BBroadbent/NotSmart-Speaker/PCB/NotSmart-Speaker/NotSmart-Speaker.kicad_pcb

## KiCad design PCB/NotSmart-Speaker/NotSmart-Speaker.kicad_pcb (2026-10-10)

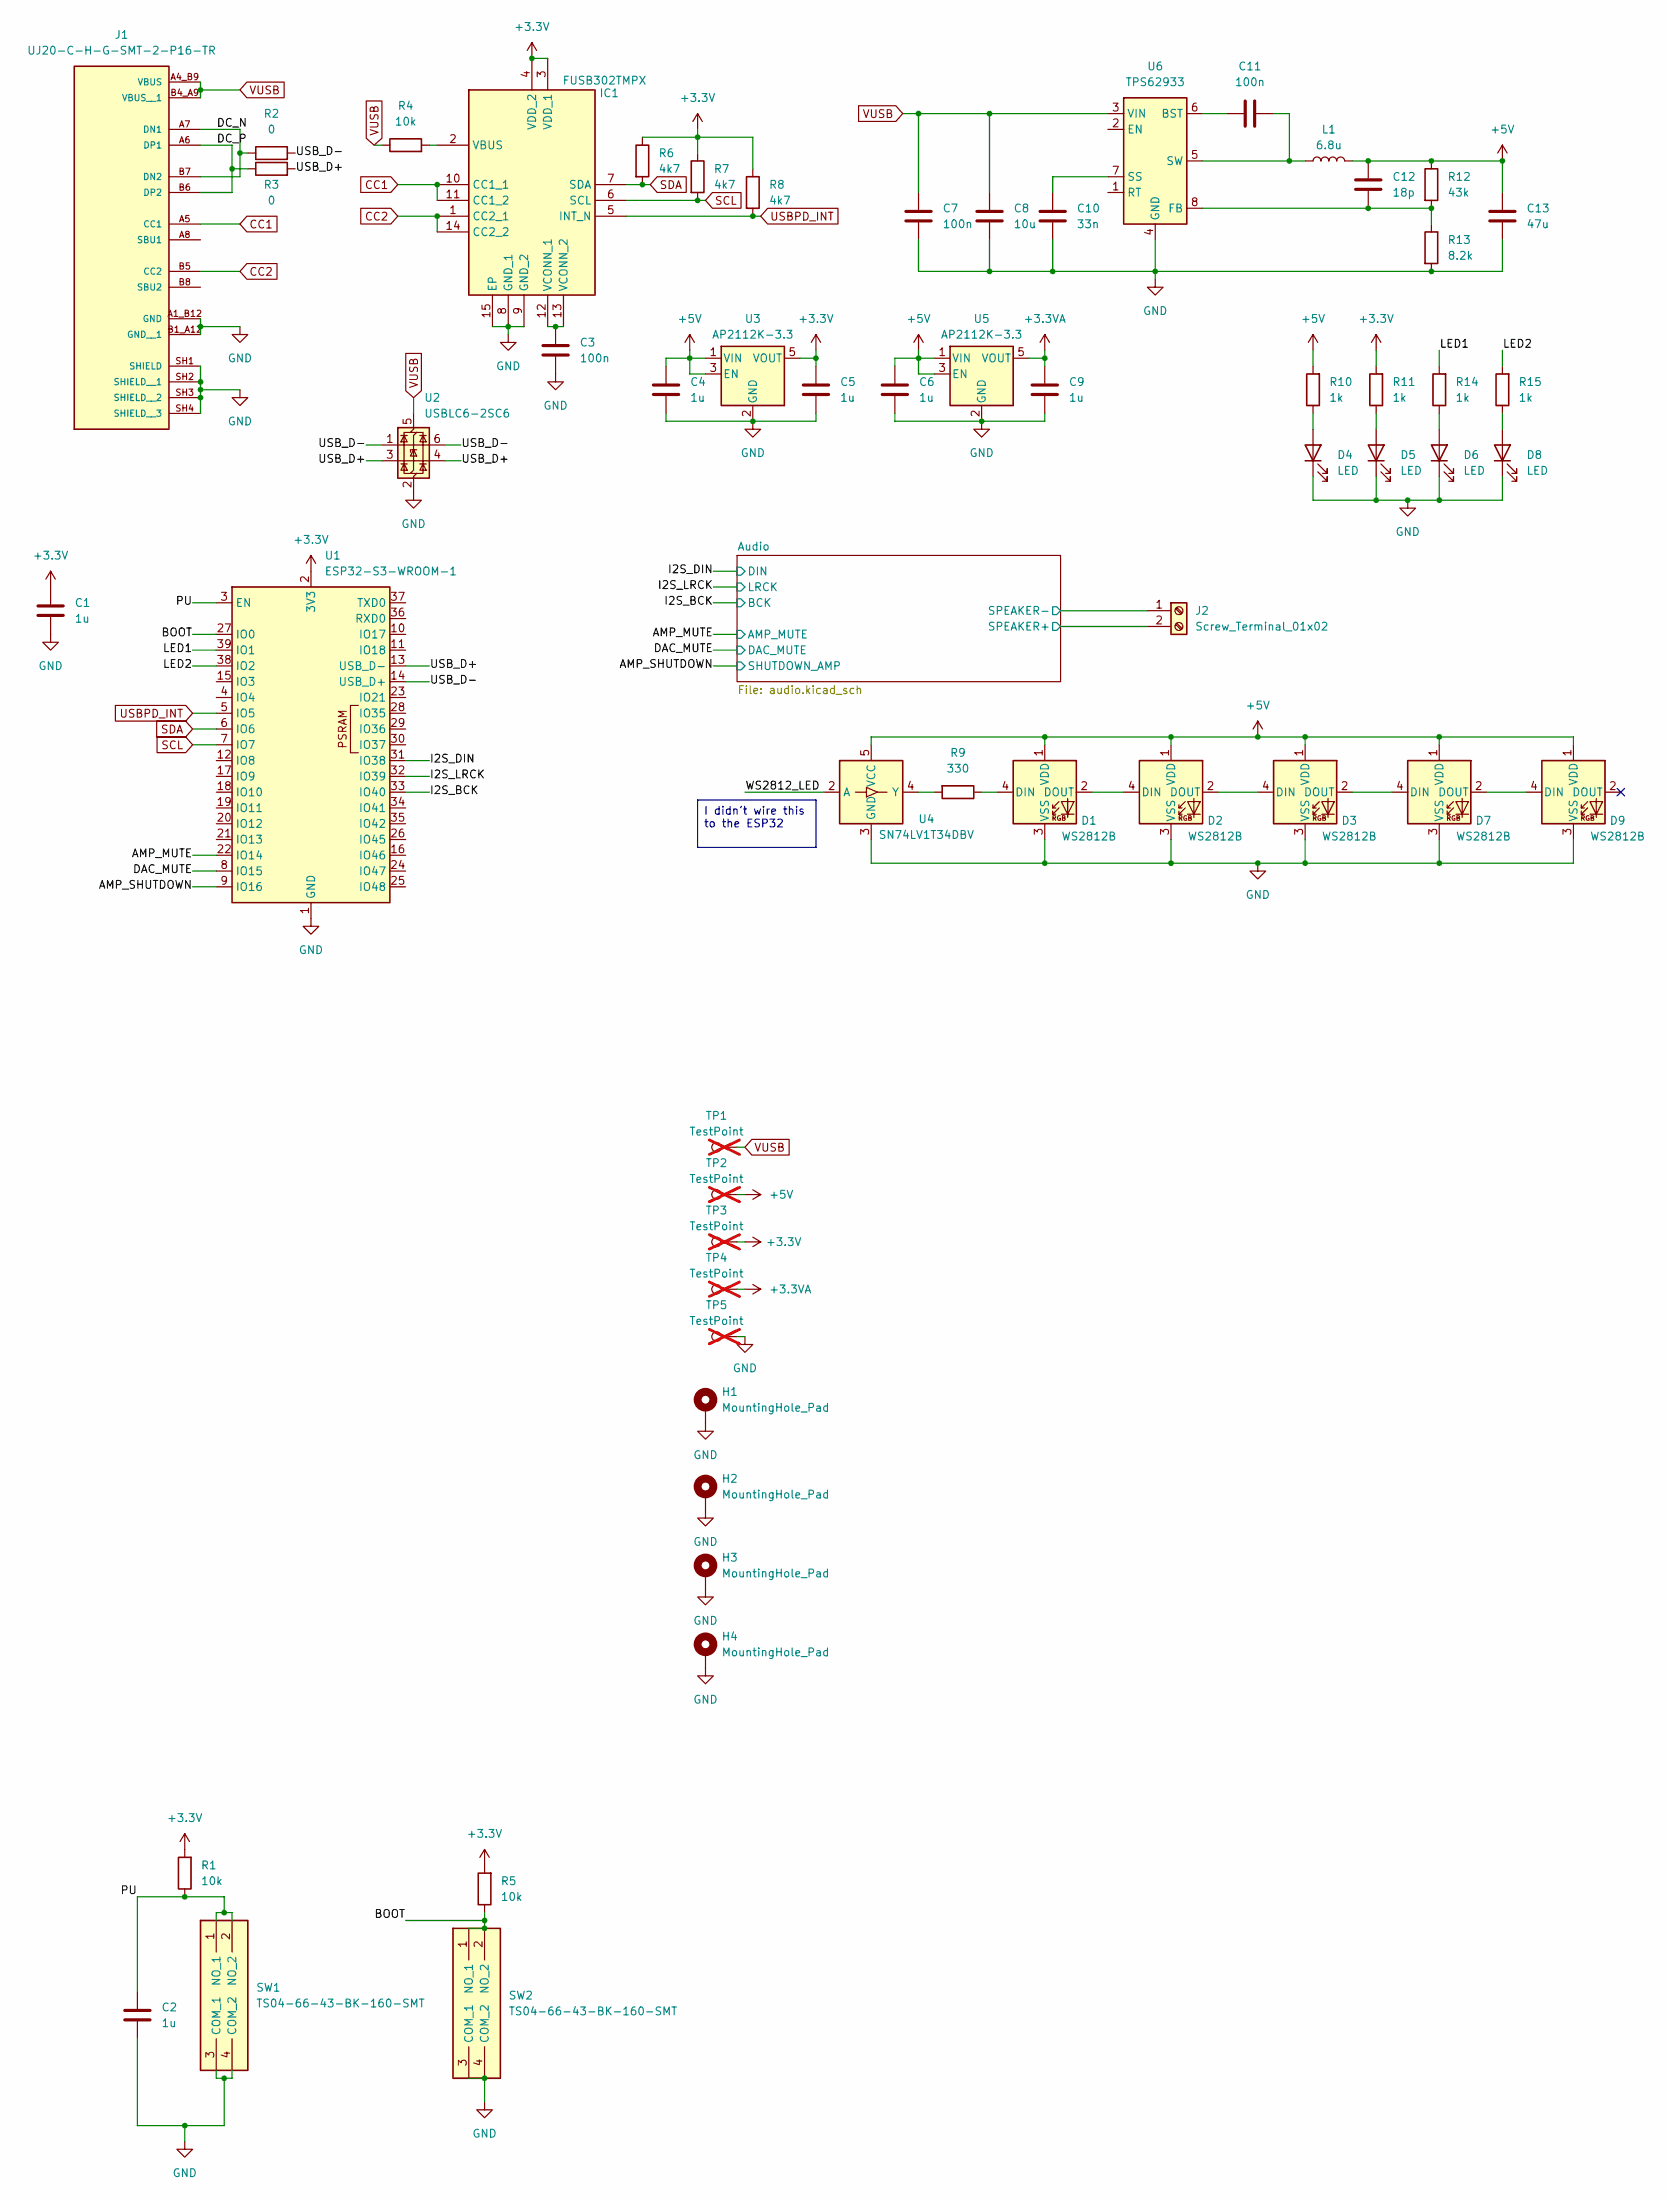
[picture p1: schematic NotSmart-Speaker.kicad_sch]

Parts:
C1, C2, C4, C5, C6, C9: 1u; C_0805_2012Metric_Pad1.18x1.45mm_HandSolder; Manufacturer_Part_Number GRM219R61H105MA73D
C3, C7, C11: 100n; C_0805_2012Metric_Pad1.18x1.45mm_HandSolder; Manufacturer_Part_Number 885012207098R
C8: 10u; C_0805_2012Metric_Pad1.18x1.45mm_HandSolder; Manufacturer_Part_Number GRM21BR61H106KE43K
C10: 33n; C_0805_2012Metric_Pad1.18x1.45mm_HandSolder; Manufacturer_Part_Number 885012207095
C12: 18p; C_0805_2012Metric_Pad1.18x1.45mm_HandSolder; Manufacturer_Part_Number 08055A180JAT4A
C13: 47u; C_0805_2012Metric_Pad1.18x1.45mm_HandSolder; Manufacturer_Part_Number MLASL21GBB5476MTNA01
D1, D2, D3, D7, D9: WS2812B; LED_WS2812B_PLCC4_5.0x5.0mm_P3.2mm
D4, D5: LED; LED_0805_2012Metric_Pad1.15x1.40mm_HandSolder; Manufacturer_Part_Number LTST-S220KGKT
D6: LED; LED_0805_2012Metric_Pad1.15x1.40mm_HandSolder; Manufacturer_Part_Number LTST-C171YKT
D8: LED; LED_0805_2012Metric_Pad1.15x1.40mm_HandSolder; Manufacturer_Part_Number 150080BS75000
H1, H2, H3, H4: MountingHole_Pad; MountingHole_3.2mm_M3_ISO14580_Pad_TopBottom
IC1: FUSB302TMPX; QFN50P250X250X80-15N; Mouser Part Number 512-FUSB302TMPX
J1: UJ20-C-H-G-SMT-2-P16-TR; SAMESKY_UJ20-C-H-G-SMT-2-P16-TR; PARTREV 1.0
J2: Screw_Terminal_01x02; TerminalBlock_Phoenix_PT-1,5-2-3.5-H_1x02_P3.50mm_Horizontal; Manufacturer_Part_Number 1751248
L1: 6.8u; WE-LHMI_7030_705048; Manufacturer_Part_Number 74437346068
R1, R4, R5: 10k; R_0805_2012Metric_Pad1.20x1.40mm_HandSolder; Manufacturer_Part_Number RC0805FR-0710KL
R2, R3: 0; R_0805_2012Metric_Pad1.20x1.40mm_HandSolder; Manufacturer_Part_Number CRCW08050000ZSTC
R6, R7, R8: 4k7; R_0805_2012Metric_Pad1.20x1.40mm_HandSolder; Manufacturer_Part_Number CR0805-FX-4701ELF
R9: 330; R_0805_2012Metric_Pad1.20x1.40mm_HandSolder; Manufacturer_Part_Number CRCW0805330RJNEA
R10, R11, R14, R15: 1k; R_0805_2012Metric_Pad1.20x1.40mm_HandSolder; Manufacturer_Part_Number AC0805FR-101KL
R12: 43k; R_0805_2012Metric_Pad1.20x1.40mm_HandSolder; Manufacturer_Part_Number ERJ-PB6B4302V
R13: 8.2k; R_0805_2012Metric_Pad1.20x1.40mm_HandSolder; Manufacturer_Part_Number ERJ-PB6B8201V
SW1, SW2: TS04-66-43-BK-160-SMT; TS046643BK160SMT; Mouser Part Number 179-TS046643BK160SMT
TP1, TP2, TP3, TP4, TP5: TestPoint; TestPoint_Pad_D1.5mm; not fitted
U1: ESP32-S3-WROOM-1; Manufacturer_Part_Number ESP32-S3-WROOM-1-N8R8
U2: USBLC6-2SC6; SOT-23-6; Manufacturer_Part_Number USBLC6-2SC6
U3, U5: AP2112K-3.3; SOT-23-5; Manufacturer_Part_Number 621-AP2112K-3.3TRG1
U4: SN74LV1T34DBV; SOT-23-5; Manufacturer_Part_Number SN74LV1T34DBVRG4
U6: TPS62933; SOT-583-8; Manufacturer_Part_Number TPS62933ODRLR

Connections:
+3.3V: C1.1, C5.1, IC1.3 (VDD_1), IC1.4 (VDD_2), R1.2, R5.2, R6.1, R7.1, R8.1, R11.2, TP3.1 (1_1), U1.2 (3V3), U3.5 (VOUT); also elsewhere on the board
+3.3VA: C9.1, TP4.1 (1_1), U5.5 (VOUT); also elsewhere on the board
+5V: C4.1, C6.1, C12.1, C13.1, D1.1 (VDD), D2.1 (VDD), D3.1 (VDD), D7.1 (VDD), D9.1 (VDD), L1.2, R10.2, R12.1, TP2.1 (1_1), U3.1 (VIN), U3.3 (EN), U4.5 (VCC), U5.1 (VIN), U5.3 (EN)
/AMP_MUTE: U1.22 (IO14); also elsewhere on the board
/AMP_SHUTDOWN: U1.9 (IO16); also elsewhere on the board
/Audio/SPEAKER+: J2.2; also elsewhere on the board
/Audio/SPEAKER-: J2.1; also elsewhere on the board
/BOOT: R5.1, SW2.1 (NO_1), SW2.2 (NO_2), U1.27 (IO0)
/DAC_MUTE: U1.8 (IO15); also elsewhere on the board
/DC_N: J1.A7 (DN1), J1.B7 (DN2), R2.1
/DC_P: J1.A6 (DP1), J1.B6 (DP2), R3.1
/I2S_BCK: U1.33 (IO40); also elsewhere on the board
/I2S_DIN: U1.31 (IO38); also elsewhere on the board
/I2S_LRCK: U1.32 (IO39); also elsewhere on the board
/LED1: R14.2, U1.39 (IO1)
/LED2: R15.2, U1.38 (IO2)
/PU: C2.1, R1.1, SW1.1 (NO_1), SW1.2 (NO_2), U1.3 (EN)
/USB_D+: R3.2, U1.13 (USB_D-), U2.3 (I/O2), U2.4 (I/O2)
/USB_D-: R2.2, U1.14 (USB_D+), U2.1 (I/O1), U2.6 (I/O1)
/WS2812_LED: U4.2 (A)
CC1: IC1.10 (CC1_1), IC1.11 (CC1_2), J1.A5 (CC1)
CC2: IC1.1 (CC2_1), IC1.14 (CC2_2), J1.B5 (CC2)
GND: C1.2, C2.2, C3.2, C4.2, C5.2, C6.2, C7.2, C8.2, C9.2, C10.2, C13.2, D1.3 (VSS), D2.3 (VSS), D3.3 (VSS), D4.1 (K), D5.1 (K), D6.1 (K), D7.3 (VSS), D8.1 (K), D9.3 (VSS), H1.1 (1_1), H2.1 (1_1), H3.1 (1_1), H4.1 (1_1), IC1.8 (GND_1), IC1.9 (GND_2), IC1.15 (EP), J1.A1_B12 (GND), J1.B1_A12 (GND__1), J1.SH1 (SHIELD), J1.SH2 (SHIELD__1), J1.SH3 (SHIELD__2), J1.SH4 (SHIELD__3), R13.2, SW1.3 (COM_1), SW1.4 (COM_2), SW2.3 (COM_1), SW2.4 (COM_2), TP5.1 (1_1), U1.1 (GND), U1.40 (GND), U1.41 (GND), U2.2 (GND), U3.2 (GND), U4.3 (GND), U5.2 (GND), U6.4 (GND); also elsewhere on the board
unnamed: D1.4 (DIN), R9.1
unnamed: D1.2 (DOUT), D2.4 (DIN)
unnamed: D2.2 (DOUT), D3.4 (DIN)
unnamed: D3.2 (DOUT), D7.4 (DIN)
unnamed: D4.2 (A), R10.1
unnamed: D5.2 (A), R11.1
unnamed: D6.2 (A), R14.1
unnamed: D7.2 (DOUT), D9.4 (DIN)
unnamed: D8.2 (A), R15.1
unnamed: IC1.2 (VBUS), R4.2
unnamed: C3.1, IC1.12 (VCONN_1), IC1.13 (VCONN_2)
unnamed: R9.2, U4.4 (Y)
unnamed: C11.1, U6.6 (BST)
unnamed: C12.2, R12.2, R13.1, U6.8 (FB)
unnamed: C10.1, U6.7 (SS)
unnamed: C11.2, L1.1, U6.5 (SW)
SCL: IC1.6 (SCL), R7.2, U1.7 (IO7)
SDA: IC1.7 (SDA), R6.2, U1.6 (IO6)
USBPD_INT: IC1.5 (INT_N), R8.2, U1.5 (IO5)
VUSB: C7.1, C8.1, J1.A4_B9 (VBUS), J1.B4_A9 (VBUS__1), R4.1, TP1.1 (1_1), U2.5 (VBUS), U6.3 (VIN); also elsewhere on the board

Notes on the sheet:
I didn't wire this to the ESP32

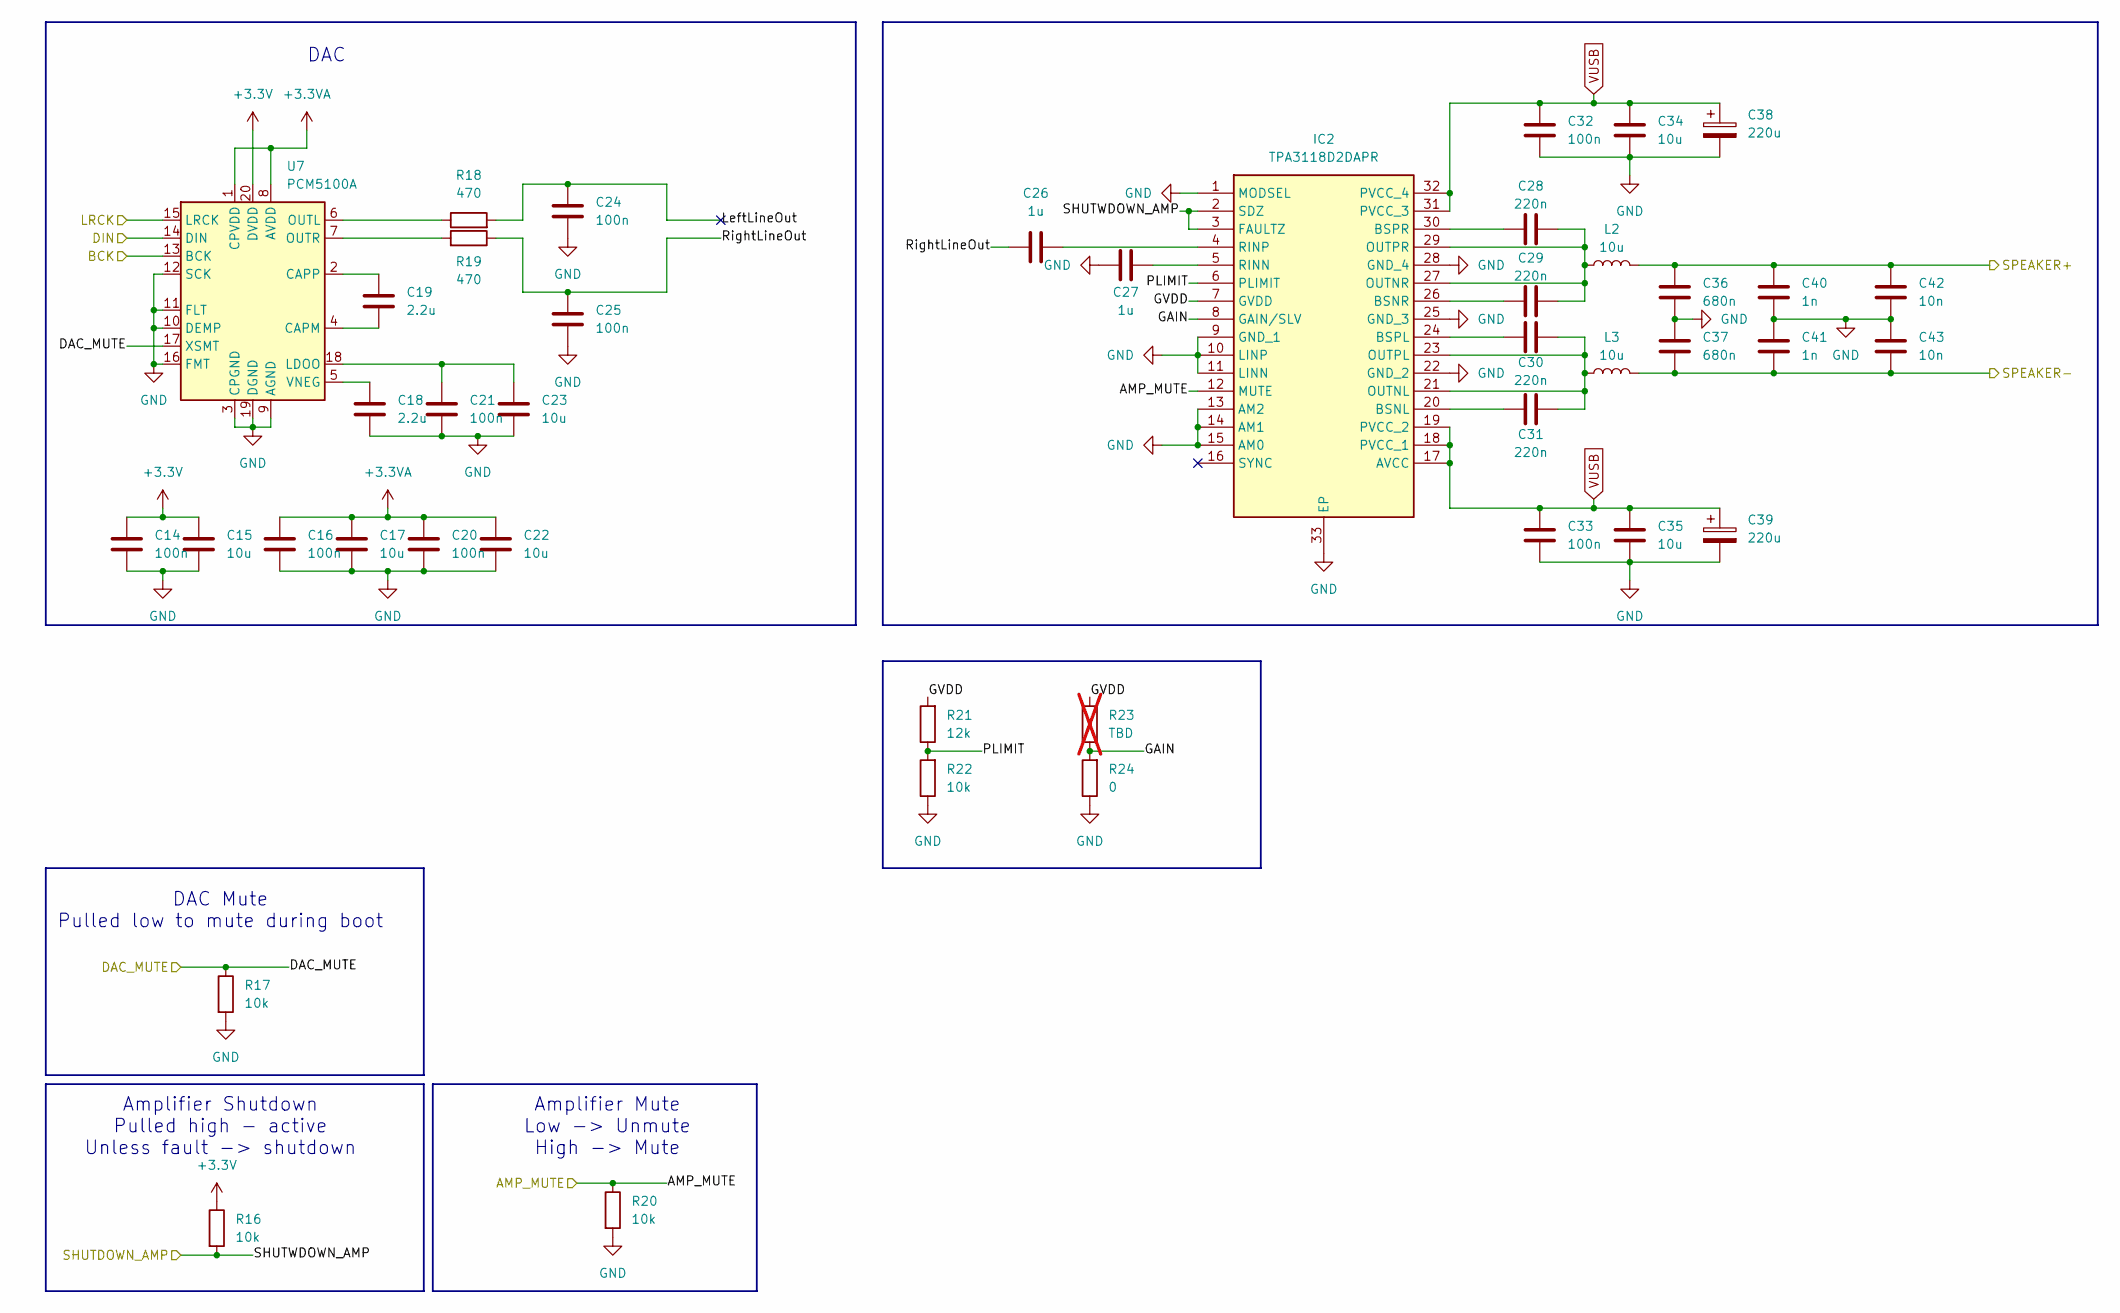
[picture p2: schematic audio.kicad_sch]

Parts:
C14, C16, C20, C21, C24, C25, C32, C33: 100n; C_0805_2012Metric_Pad1.18x1.45mm_HandSolder; Manufacturer_Part_Number 885012207098R
C15, C17, C22, C23: 10u; C_0805_2012Metric_Pad1.18x1.45mm_HandSolder; Manufacturer_Part_Number GRM21BR61H106KE43K
C18, C19: 2.2u; C_0805_2012Metric_Pad1.18x1.45mm_HandSolder; Manufacturer_Part_Number CL21B225KAFNNNE
C26, C27: 1u; C_0805_2012Metric_Pad1.18x1.45mm_HandSolder; Manufacturer_Part_Number GRM219R61H105MA73D
C28, C29, C30, C31: 220n; C_0805_2012Metric_Pad1.18x1.45mm_HandSolder; Manufacturer_Part_Number CL21B225KBYNNWE
C34, C35: 10u; C_1206_3216Metric_Pad1.33x1.80mm_HandSolder; Manufacturer_Part_Number GRM31CR71E106MA12L
C36, C37: 680n; C_1206_3216Metric_Pad1.33x1.80mm_HandSolder; Manufacturer_Part_Number 885012208092
C38, C39: 220u; CP_Elec_10x10; Manufacturer_Part_Number EEH-ZS1H221P
C40, C41: 1n; C_0805_2012Metric_Pad1.18x1.45mm_HandSolder; Manufacturer_Part_Number 885012207086
C42, C43: 10n; C_0805_2012Metric_Pad1.18x1.45mm_HandSolder; Manufacturer_Part_Number 08055C103KAT2A
IC2: TPA3118D2DAPR; SOP65P810X120-33N; Mouser Part Number 595-TPA3118D2DAPR
L2, L3: 10u; WE-LHMI_7030_705048; Manufacturer_Part_Number 74437346100
R16, R17, R20, R22: 10k; R_0805_2012Metric_Pad1.20x1.40mm_HandSolder; Manufacturer_Part_Number RC0805FR-0710KL
R18, R19: 470; R_0805_2012Metric_Pad1.20x1.40mm_HandSolder; Manufacturer_Part_Number CR0805-JW-471ELF
R21: 12k; R_0805_2012Metric_Pad1.20x1.40mm_HandSolder; Manufacturer_Part_Number CRCW080512K0JNEA
R23: TBD; R_0805_2012Metric_Pad1.20x1.40mm_HandSolder; not fitted
R24: 0; R_0805_2012Metric_Pad1.20x1.40mm_HandSolder; Manufacturer_Part_Number CRCW08050000ZSTC
U7: PCM5100A; TSSOP-20_4.4x6.5mm_P0.65mm; Manufacturer_Part_Number PCM5100APWR

Connections:
+3.3V: C14.1, C15.1, R16.1, U7.20 (DVDD); also elsewhere on the board
+3.3VA: C16.1, C17.1, C20.1, C22.1, U7.1 (CPVDD), U7.8 (AVDD); also elsewhere on the board
/AMP_MUTE: IC2.12 (MUTE), R20.1; also elsewhere on the board
/AMP_SHUTDOWN: IC2.2 (SDZ), IC2.3 (FAULTZ), R16.2; also elsewhere on the board
/Audio/GAIN: IC2.8 (GAIN/SLV), R23.1, R24.2
/Audio/GVDD: IC2.7 (GVDD), R21.2, R23.2
/Audio/LeftLineOut: C24.1, R18.2
/Audio/PLIMIT: IC2.6 (PLIMIT), R21.1, R22.2
/Audio/RightLineOut: C25.1, C26.1, R19.1
/Audio/SPEAKER+: C36.1, C40.1, C42.1, L2.2; also elsewhere on the board
/Audio/SPEAKER-: C37.2, C41.2, C43.2, L3.2; also elsewhere on the board
/DAC_MUTE: R17.1, U7.17 (XSMT); also elsewhere on the board
/I2S_BCK: U7.13 (BCK); also elsewhere on the board
/I2S_DIN: U7.14 (DIN); also elsewhere on the board
/I2S_LRCK: U7.15 (LRCK); also elsewhere on the board
GND: C14.2, C15.2, C16.2, C17.2, C18.2, C20.2, C21.2, C22.2, C23.2, C24.2, C25.2, C27.1, C32.2, C33.2, C34.2, C35.2, C36.2, C37.1, C38.2, C39.2, C40.2, C41.1, C42.2, C43.1, IC2.1 (MODSEL), IC2.9 (GND_1), IC2.10 (LINP), IC2.11 (LINN), IC2.13 (AM2), IC2.14 (AM1), IC2.15 (AM0), IC2.22 (GND_2), IC2.25 (GND_3), IC2.28 (GND_4), IC2.33 (EP), R17.2, R20.2, R22.1, R24.1, U7.3 (CPGND), U7.9 (AGND), U7.10 (DEMP), U7.11 (FLT), U7.12 (SCK), U7.16 (FMT), U7.19 (DGND); also elsewhere on the board
unnamed: C31.1, IC2.20 (BSNL)
unnamed: C29.1, IC2.26 (BSNR)
unnamed: C30.1, IC2.24 (BSPL)
unnamed: C28.1, IC2.30 (BSPR)
unnamed: C30.2, C31.2, IC2.21 (OUTNL), IC2.23 (OUTPL), L3.1
unnamed: C28.2, C29.2, IC2.27 (OUTNR), IC2.29 (OUTPR), L2.1
unnamed: C27.2, IC2.5 (RINN)
unnamed: C26.2, IC2.4 (RINP)
unnamed: C19.2, U7.4 (CAPM)
unnamed: C19.1, U7.2 (CAPP)
unnamed: C21.1, C23.1, U7.18 (LDOO)
unnamed: R18.1, U7.6 (OUTL)
unnamed: R19.2, U7.7 (OUTR)
unnamed: C18.1, U7.5 (VNEG)
VUSB: C32.1, C33.1, C34.1, C35.1, C38.1, C39.1, IC2.17 (AVCC), IC2.18 (PVCC_1), IC2.19 (PVCC_2), IC2.31 (PVCC_3), IC2.32 (PVCC_4); also elsewhere on the board

Notes on the sheet:
DAC
Amplifier Shutdown Pulled high - active Unless fault -> shutdown
DAC Mute Pulled low to mute during boot
Amplifier Mute Low -> Unmute High -> Mute

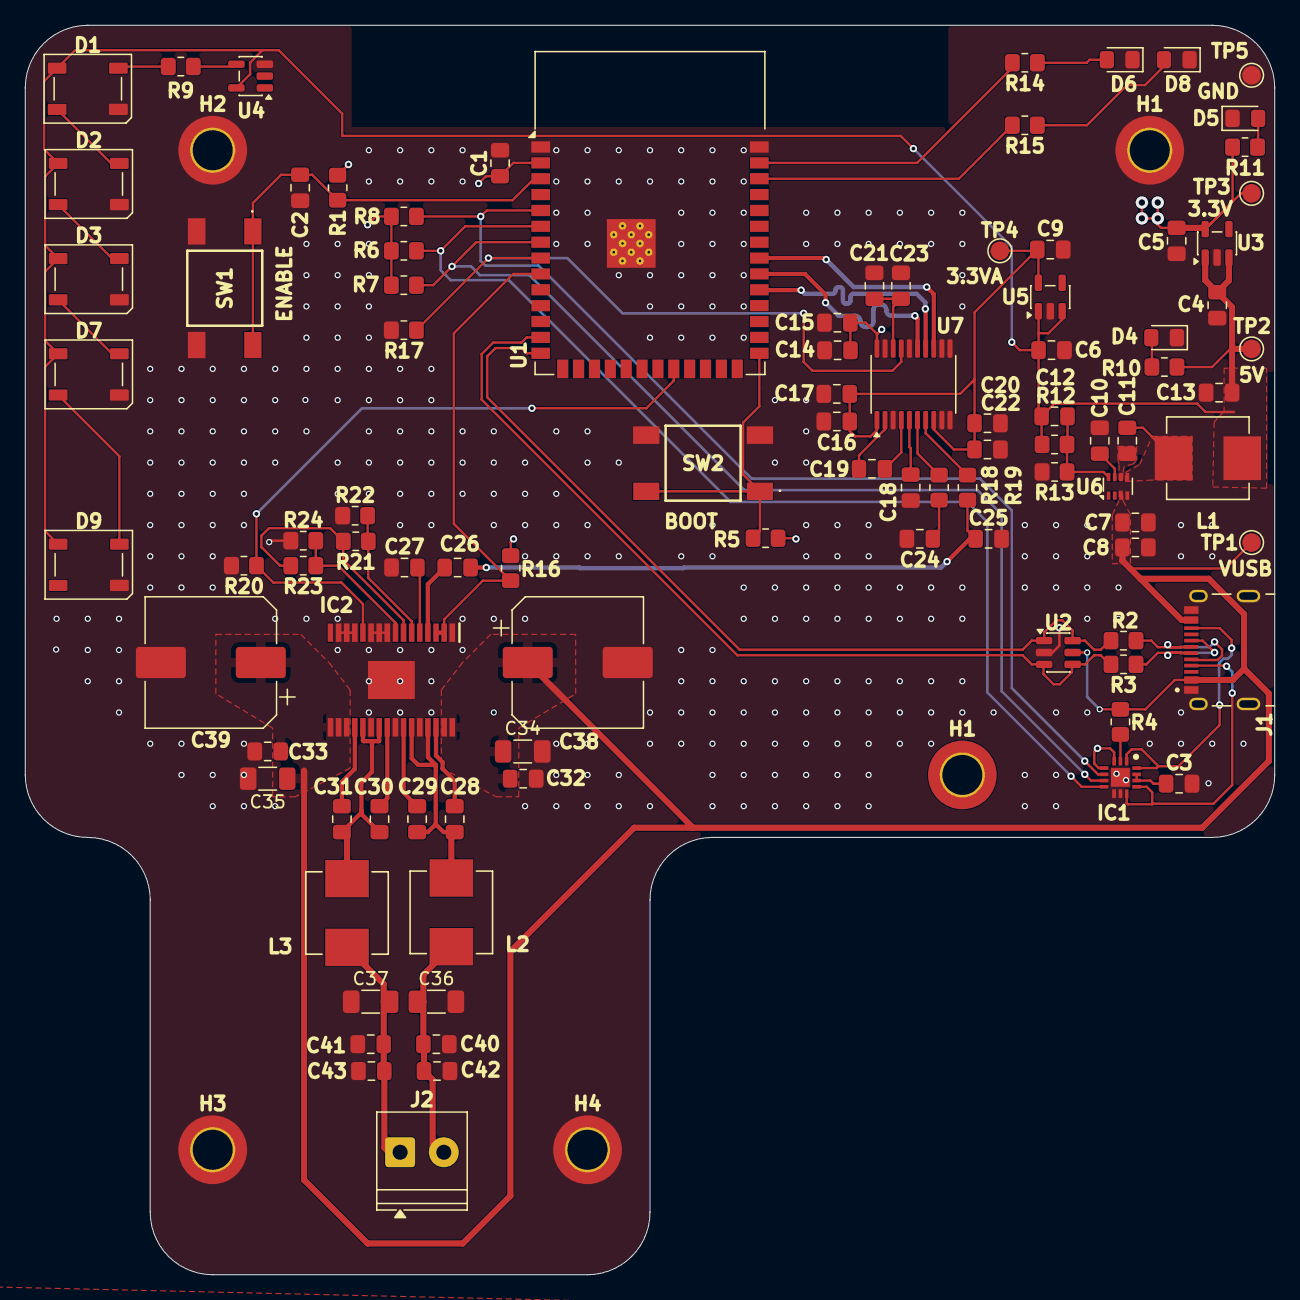
[picture p3: board NotSmart-Speaker.kicad_pcb from above]

Board: 4 copper layers, 100.0 x 100.0 mm, 102 parts (0 on the bottom side), 61 nets.

Other parts of the board:
H1#2: MountingHole_Pad; MountingHole_3.2mm_M3_ISO14580_Pad_TopBottom
